thanhnt2410/forklift/Các-tính-năg-chính.docx

1. Các tính năng chính

Với mô hình hiện tại gồm ESP32 + Raspberry Pi 4B + LiDAR YDLiDAR X4 + 4 động cơ GA25A370 12V + BTS7960 + TB6600/NEMA23 nâng hạ vít me, xây dựng xe theo hướng AMR vận chuyển hàng có càng nâng, điều khiển thủ công và tự hành trong nhà.

a) Điều khiển di chuyển thủ công
- Tiến, lùi, rẽ trái, rẽ phải, dừng khẩn cấp.
- Điều khiển bằng bàn phím máy tính qua Serial ở giai đoạn thử nghiệm.
- Có thể phát triển điều khiển từ Raspberry Pi qua ROS 2.
- Tùy cấu hình bánh và cách đấu động cơ, có thể bổ sung đi ngang và xoay tại chỗ.
- Phần cứng: ESP32, BTS7960, 4 động cơ DC.
b) Quét môi trường và lập bản đồ 2D
- Quét tường, hành lang, kệ hàng và các vật cản phản xạ laser.
- Tạo bản đồ 2D khi xe di chuyển trong khu vực thử nghiệm.
- Hiển thị dữ liệu laser trên RViz2.
- Phần cứng: YDLiDAR X4.
- Phần mềm: ROS 2 Humble, driver YDLiDAR, SLAM Toolbox.
c) Tự định vị và tự hành đến điểm đích
- Xây dựng bản đồ trước, sau đó xác định vị trí xe trên bản đồ.
- Chọn điểm đích trên RViz2.
- Lập đường đi và điều chỉnh hướng di chuyển.
- Phần mềm: ROS 2 Humble, AMCL hoặc phương pháp định vị phù hợp, Nav2.
- Cần thêm odometry đáng tin cậy từ encoder và cấu hình đúng động học bánh xe.
d) Nâng hạ càng để lấy và đặt hàng
- Nâng càng đến độ cao yêu cầu.
- Hạ càng để lấy hoặc đặt kiện hàng.
- Điều khiển động cơ bước NEMA23 bằng TB6600.
- Có thể xây dựng các mức nâng định sẵn, ví dụ vị trí thấp, trung bình và cao.
e) Đo tốc độ và tính odometry bằng encoder
- Đọc xung encoder của từng bánh.
- Tính RPM thực tế và tốc độ bánh xe.
- So sánh tốc độ đặt với tốc độ thực để hiệu chỉnh bằng PID.
- Tính quãng đường và góc quay tương đối của xe.
- Đây là phần rất quan trọng để Nav2 điều hướng ổn định; cần hiệu chuẩn số xung và động học thực tế.

2. Các tính năng mở rộng nên có

Tính năng | Thiết bị/phần mềm sử dụng | Mức ưu tiên
Điều khiển bằng máy tính | ESP32 + Serial
Điều khiển bằng bàn phím trên ROS 2 | teleop_twist_keyboard | Nên có
Hiển thị bản đồ và vị trí xe | RViz2 + SLAM Toolbox | Nên có
Tự hành đến tọa độ đích | Nav2 + odometry | Mục tiêu chính
Phát hiện vật cản phía trước và xung quanh | LiDAR + Nav2 Costmap | Nên có
Đo RPM 4 bánh | 4 encoder | Nên có
Điều khiển tốc độ bánh bằng PID | ESP32 | Nên có
Nâng/hạ tự động theo vị trí | TB6600 + NEMA23 | Nên có
Dừng khẩn cấp | Nút E-stop và mạch ngắt nguồn động cơ | Bắt buộc về an toàn
Giám sát pin và điện áp | Cảm biến điện áp/dòng phù hợp | Mở rộng
Giao diện điều khiển trên máy tính | RViz2 hoặc giao diện riêng | Mở rộng
Tự động lấy hàng và giao hàng | Nav2 + điều khiển nâng hạ + logic nhiệm vụ | Mục tiêu nâng cao
