thanhnt2410/forklift/docs/images/Green_line.gif

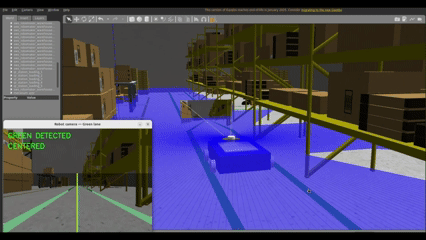
docs/images/Green_line.gif
