thanhnt2410/forklift/docs/images/Lift_system.gif

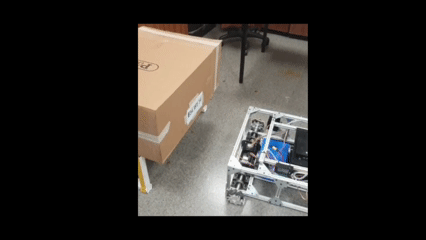
docs/images/Lift_system.gif
