thanhnt2410/forklift/docs/images/localization.gif

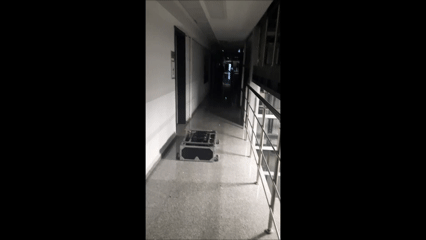
docs/images/localization.gif
