thanhnt2410/forklift/docs/images/mapping.gif

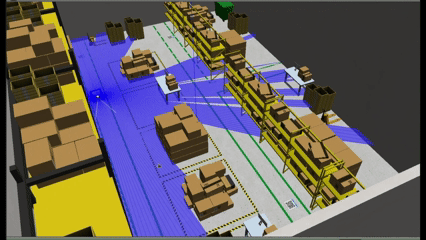
docs/images/mapping.gif
