thanhnt2410/forklift/src/forklift_navigation/maps/forklift_sim_probability.png

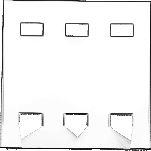
src/forklift_navigation/maps/forklift_sim_probability.png
