thanhnt2410/forklift/src/mecanum_navigation/maps/home_probability.png

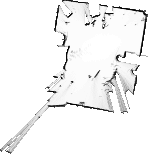
src/mecanum_navigation/maps/home_probability.png
