thanhnt2410/forklift/src/forklift_description/cad_source/meshes/base_link.STL

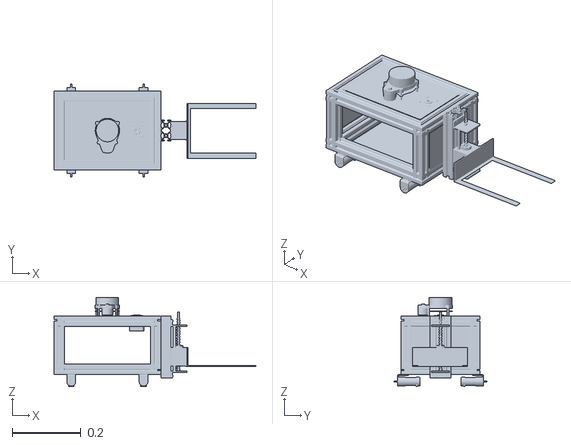
[picture p9: CAD file, 2026-10-24]
src/forklift_description/cad_source/meshes/base_link.STL
0.586 x 0.269 x 0.26
