thanhnt2410/forklift/src/forklift_description/meshes/lift_drive_gear.stl

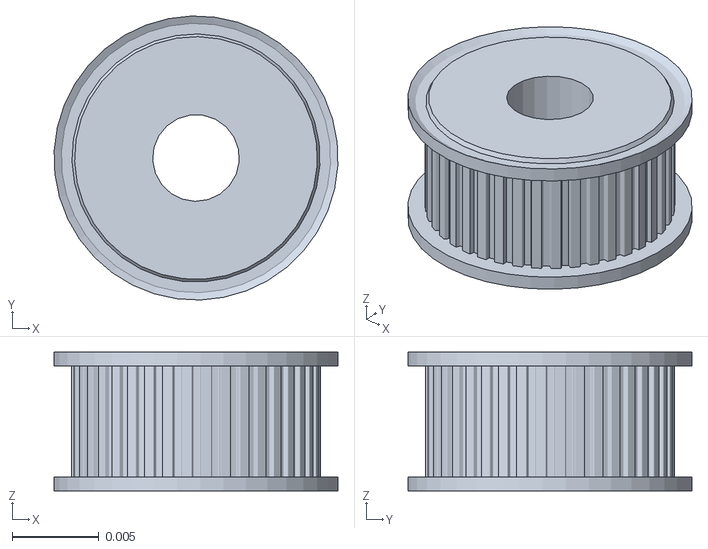
[picture p10: CAD file, 2026-10-24]
src/forklift_description/meshes/lift_drive_gear.stl
0.0164 x 0.0164 x 0.008
