thanhnt2410/forklift/src/forklift_description/cad_source/meshes/banh2_Link.STL

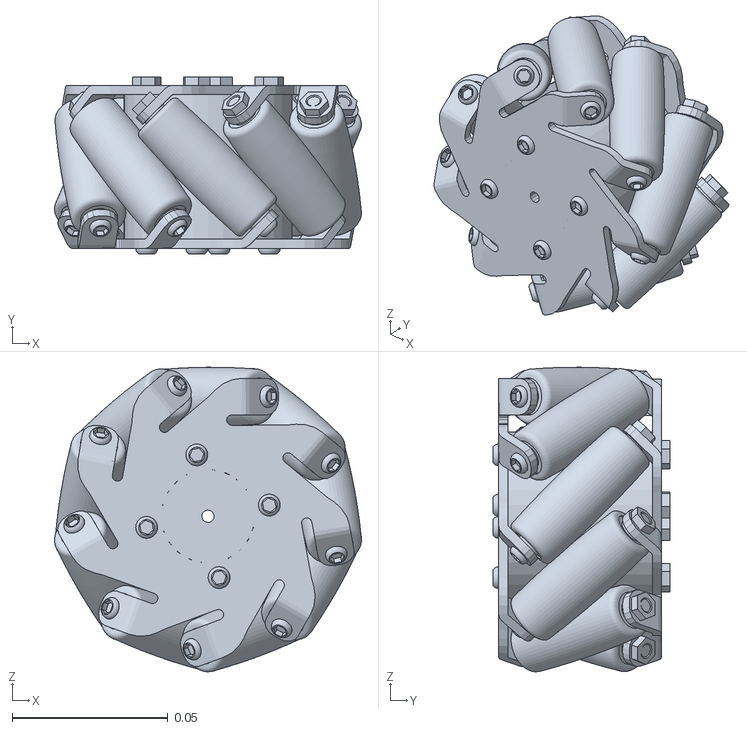
[picture p11: CAD file, 2026-10-24]
src/forklift_description/cad_source/meshes/banh2_Link.STL
0.0985 x 0.0568 x 0.0977
