thanhnt2410/forklift/src/forklift_description/cad_source/meshes/lidar_Link.STL

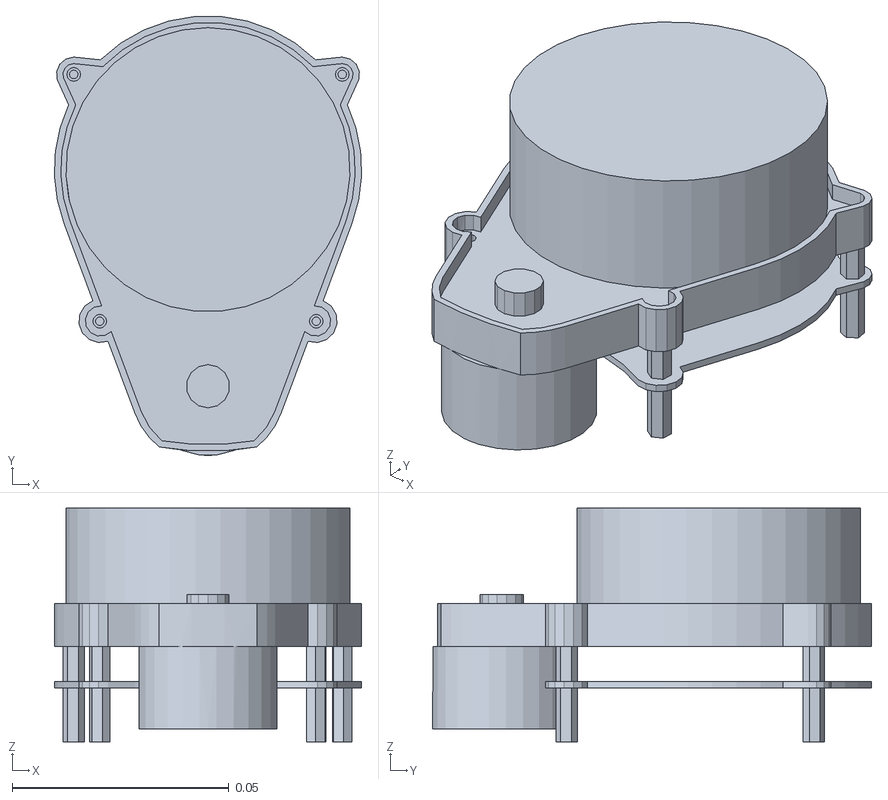
[picture p12: CAD file, 2026-10-24]
src/forklift_description/cad_source/meshes/lidar_Link.STL
0.0709 x 0.101 x 0.054
