thanhnt2410/forklift/src/forklift_description/cad_source/meshes/step_Link.STL

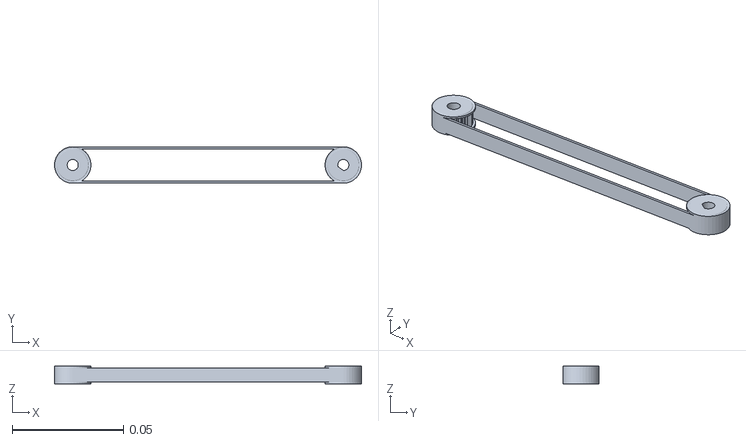
[picture p13: CAD file, 2026-10-24]
src/forklift_description/cad_source/meshes/step_Link.STL
0.138 x 0.0164 x 0.008
