thanhnt2410/forklift/src/forklift_description/cad_source/meshes/banhrang2_Link.STL

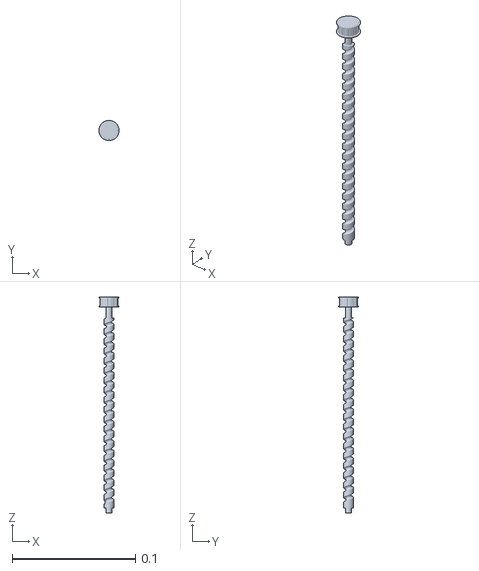
[picture p14: CAD file, 2026-10-24]
src/forklift_description/cad_source/meshes/banhrang2_Link.STL
0.0164 x 0.0164 x 0.175
