thanhnt2410/forklift/src/forklift_description/meshes/lift_carriage.stl

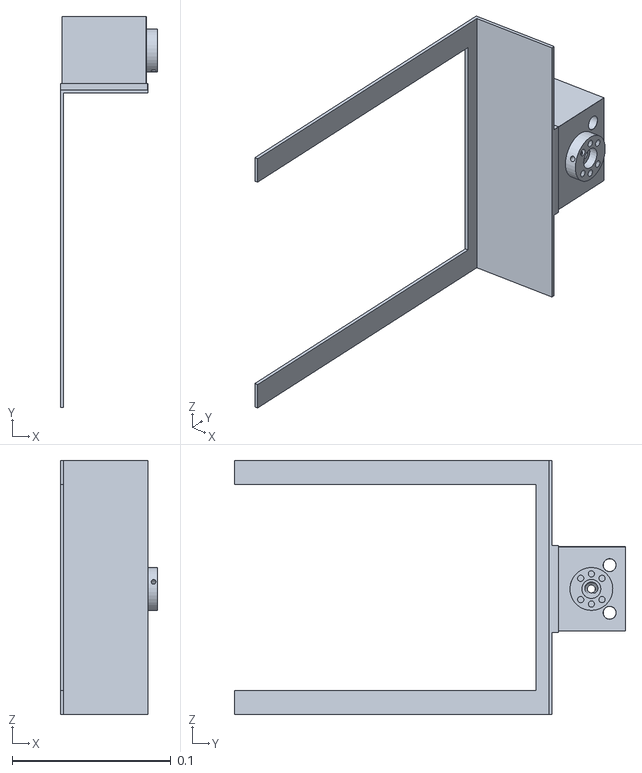
[picture p15: CAD file, 2026-10-24]
src/forklift_description/meshes/lift_carriage.stl
0.0611 x 0.246 x 0.16
