thanhnt2410/forklift/src/forklift_description/meshes/chassis.stl

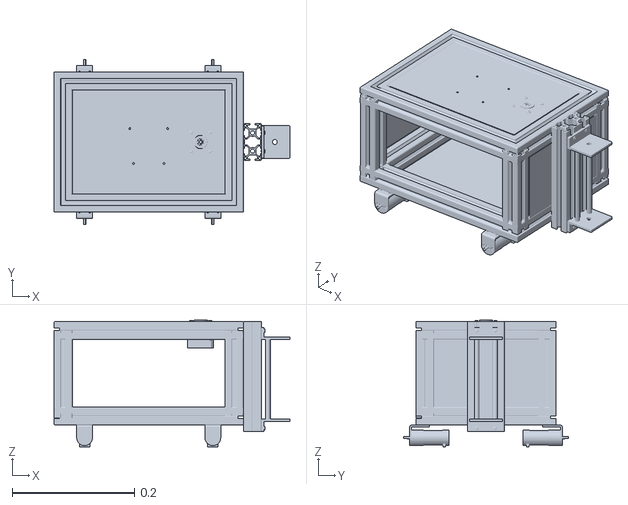
[picture p16: CAD file, 2026-10-24]
src/forklift_description/meshes/chassis.stl
0.386 x 0.269 x 0.208
