thanhnt2410/forklift/(list of files, cad)

Other CAD files:
src/forklift_description/cad_source/meshes/banh1_Link.STL
src/forklift_description/meshes/front_left_wheel.stl
src/forklift_description/cad_source/meshes/banh3_Link.STL
src/forklift_description/meshes/rear_left_wheel.stl
src/forklift_description/cad_source/meshes/banh4_Link.STL
src/forklift_description/meshes/rear_right_wheel.stl
