thanhnt2410/forklift/results/final/dynamic_mission/cancel/mission.csv

t | state | robot_x | robot_y | robot_yaw | pallet_x | pallet_y | pallet_z | pallet_yaw | vx | vy | wz | load | map_x | map_y | map_yaw
505829.196282791 | IDLE | 2.664535259100348e-21 | -4.996264735268596e-22 | -8.326672684688766e-23 | 0.95 | 0.65 | -1.8797065771958278e-11 | -5.383505475921094e-21 | 0.0 | 0.0 | 0.0 | False
505829.316199245 | IDLE | 2.664535259100348e-21 | -4.996264735268596e-22 | -8.326672684688766e-23 | 0.95 | 0.65 | -1.8797065771958278e-11 | -5.383505475921094e-21 | 0.0 | 0.0 | 0.0 | False
505829.416253594 | IDLE | 2.664535259100348e-21 | -4.996264735268596e-22 | -8.326672684688766e-23 | 0.95 | 0.65 | -1.8797065771958278e-11 | -5.383505475921094e-21 | 0.0 | 0.0 | 0.0 | False
505829.536256974 | IDLE | 2.664535259100348e-21 | -4.996264735268596e-22 | -8.326672684688766e-23 | 0.95 | 0.65 | -1.8797065771958278e-11 | -5.383505475921094e-21 | 0.0 | 0.0 | 0.0 | False
505829.658235333 | IDLE | 2.664535259100348e-21 | -4.996264735268596e-22 | -8.326672684688766e-23 | 0.95 | 0.65 | -1.8797065771958278e-11 | -5.383505475921094e-21 | 0.0 | 0.0 | 0.0 | False
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
