thanhnt2410/forklift/results/final/dynamic_mission/cancel_loaded/mission.csv

t | state | robot_x | robot_y | robot_yaw | pallet_x | pallet_y | pallet_z | pallet_yaw | vx | vy | wz | load | map_x | map_y | map_yaw
505093.903661811 | IDLE | 5.329070518200689e-21 | -9.993443406131062e-22 | -1.6653345369377553e-22 | 0.95 | 0.65 | -1.8797065771958278e-11 | -5.383505475921094e-21 | 0.0 | 0.0 | 0.0 | False
505094.003791012 | IDLE | 5.329070518200689e-21 | -9.993443406131062e-22 | -1.6653345369377553e-22 | 0.95 | 0.65 | -1.8797065771958278e-11 | -5.383505475921094e-21 | 0.0 | 0.0 | 0.0 | False
505094.115979718 | IDLE | 8.881784197001143e-21 | -1.6657915047346703e-21 | -2.775557561562927e-22 | 0.95 | 0.65 | -1.8797065771958278e-11 | -5.383505475921094e-21 | 0.0 | 0.0 | 0.0 | False
505094.217679768 | IDLE | -3.203749560791486e-12 | 1.1670537655607396e-16 | -1.2320145530614313e-16 | 0.95 | 0.65 | -1.8797065771958278e-11 | -5.383505475921094e-21 | 0.0 | 0.0 | 0.0 | False
505094.320802347 | IDLE | -3.1967335971082835e-12 | 1.155458278260727e-16 | 3.805693524072221e-18 | 0.95 | 0.65 | -1.8797065771958278e-11 | -5.383505475921094e-21 | 0.0 | 0.0 | 0.0 | False
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
