thanhnt2410/forklift/results/final/dynamic_mission/cancel_retreat/mission.csv

t | state | robot_x | robot_y | robot_yaw | pallet_x | pallet_y | pallet_z | pallet_yaw | vx | vy | wz | load | map_x | map_y | map_yaw
505613.166576521 | IDLE | 5.329070518200689e-21 | -9.993443406131062e-22 | -1.6653345369377553e-22 | 0.95 | 0.65 | -1.8797065771958278e-11 | -5.383505475921094e-21 | 0.0 | 0.0 | 0.0 | False
505613.266662494 | IDLE | 5.329070518200689e-21 | -9.993443406131062e-22 | -1.6653345369377553e-22 | 0.95 | 0.65 | -1.8797065771958278e-11 | -5.383505475921094e-21 | 0.0 | 0.0 | 0.0 | False
505613.366690486 | IDLE | 2.0516921495072616e-19 | -3.8296269111448573e-20 | -6.300515664747855e-21 | 0.95 | 0.65 | -1.8797065771958278e-11 | -5.383505475921094e-21 | 0.0 | 0.0 | 0.0 | False
505613.476316733 | IDLE | -3.2242751532534784e-12 | 1.1681044982727404e-16 | 6.959117667158027e-18 | 0.95 | 0.65 | -1.8797065771958278e-11 | -5.383505475921094e-21 | 0.0 | 0.0 | 0.0 | False
505613.578556104 | IDLE | -3.1919660442139026e-12 | 1.1533879076530136e-16 | 2.866845469283098e-18 | 0.95 | 0.65 | -1.8797065771958278e-11 | -5.383505475921094e-21 | 0.0 | 0.0 | 0.0 | False
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
