thanhnt2410/forklift/results/final/dynamic_mission/missing_pallet/mission.csv

t | state | robot_x | robot_y | robot_yaw | pallet_x | pallet_y | pallet_z | pallet_yaw | vx | vy | wz | load | map_x | map_y | map_yaw
505788.208965822 | IDLE | 5.329070518200689e-21 | -9.993443406131062e-22 | -1.6653345369377553e-22 | 0.95 | 0.65 | -1.8797065771958278e-11 | -5.383505475921094e-21 | 0.0 | 0.0 | 0.0 | False
505788.309220934 | IDLE | 5.329070518200689e-21 | -9.993443406131062e-22 | -1.6653345369377553e-22 | 0.95 | 0.65 | -1.8797065771958278e-11 | -5.383505475921094e-21 | 0.0 | 0.0 | 0.0 | False
505788.414321522 | IDLE | -1.3649508706186334e-12 | 4.979940459223876e-17 | -1.2315060863321484e-16 | 0.95 | 0.65 | -1.8797065771958278e-11 | -5.383505475921094e-21 | 0.0 | 0.0 | 0.0 | False
505788.516046535 | IDLE | -3.2258210401427543e-12 | 1.1687960493035809e-16 | 7.088909870699133e-18 | 0.95 | 0.65 | -1.8797065771958278e-11 | -5.383505475921094e-21 | 0.0 | 0.0 | 0.0 | False
505788.616062694 | IDLE | -3.1919660442139026e-12 | 1.1533879076530136e-16 | 2.866845469283098e-18 | 0.95 | 0.65 | -1.8797065771958278e-11 | -5.383505475921094e-21 | 0.0 | 0.0 | 0.0 | False
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
