thanhnt2410/forklift/results/final/dynamic_mission/nominal/mission.csv

t | state | robot_x | robot_y | robot_yaw | pallet_x | pallet_y | pallet_z | pallet_yaw | vx | vy | wz | load | map_x | map_y | map_yaw
505355.83696218 | IDLE | 5.329070518200689e-21 | -9.993443406131062e-22 | -1.6653345369377553e-22 | 0.95 | 0.65 | -1.8797065771958278e-11 | -5.383505475921094e-21 | 0.0 | 0.0 | 0.0 | False
505355.9568166 | IDLE | 5.329070518200689e-21 | -9.993443406131062e-22 | -1.6653345369377553e-22 | 0.95 | 0.65 | -1.8797065771958278e-11 | -5.383505475921094e-21 | 0.0 | 0.0 | 0.0 | False
505356.057495927 | IDLE | -2.8399713232431403e-12 | 1.0347196321373233e-16 | -1.2318442889347137e-16 | 0.95 | 0.65 | -1.8797065771958278e-11 | -5.383505475921094e-21 | 0.0 | 0.0 | 0.0 | False
505356.1626632 | IDLE | -3.201927957424886e-12 | 1.1578344205757187e-16 | 4.5900658202533585e-18 | 0.95 | 0.65 | -1.8797065771958278e-11 | -5.383505475921094e-21 | 0.0 | 0.0 | 0.0 | False
505356.262877041 | IDLE | -3.1889004815557215e-12 | 1.1519857523973847e-16 | 1.963313044791957e-18 | 0.95 | 0.65 | -1.8797065771958278e-11 | -5.383505475921094e-21 | 0.0 | 0.0 | 0.0 | False
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
