thanhnt2410/forklift/results/final/dynamic_mission/legacy/mission.csv

t | sim_t | state | load | pallet_x | pallet_y | pallet_z | robot_z | robot_roll | robot_pitch | raw_lift | robot_yaw | pallet_yaw | robot_x | robot_y | cmd_x | cmd_y | cmd_w | nav_cmd_x | nav_cmd_w | mission_cmd_x | nav_cmd_y | source | odom_vy | map_x | map_y | map_yaw
505870.76597848 | 0.003 | IDLE | False | 0.95 | 0.65 | -1.8797065771958278e-11 | 0.004941200000000001 | -7.993605777301129e-21 | 5.145439123960323e-34 | 0.0 | -1.6653345369377553e-22 | -5.383505475918921e-21 | 5.329070518200689e-21 | -9.993443406131062e-22 | 0.0 | 0.0 | 0.0 | 0.0 | 0.0 | 0.0 | 0.0 | NAV2 | 0.0
505870.879032238 | 0.003 | IDLE | False | 0.95 | 0.65 | -1.8797065771958278e-11 | 0.004941200000000001 | -7.993605777301129e-21 | 5.145439123960323e-34 | 0.0 | -1.6653345369377553e-22 | -5.383505475918921e-21 | 5.329070518200689e-21 | -9.993443406131062e-22 | 0.0 | 0.0 | 0.0 | 0.0 | 0.0 | 0.0 | 0.0 | NAV2 | 0.0
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
