thanhnt2410/forklift/results/final/dynamic_mission/validation/rviz.png

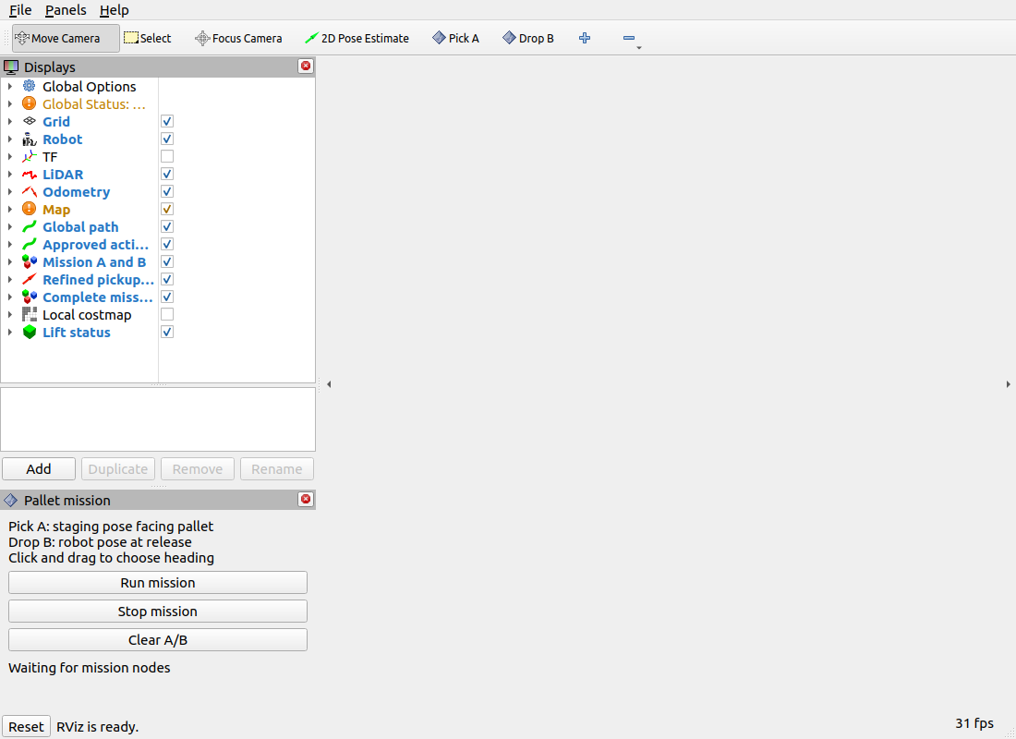
results/final/dynamic_mission/validation/rviz.png
