thanhnt2410/forklift/results/final/early_detection/trajectories.png

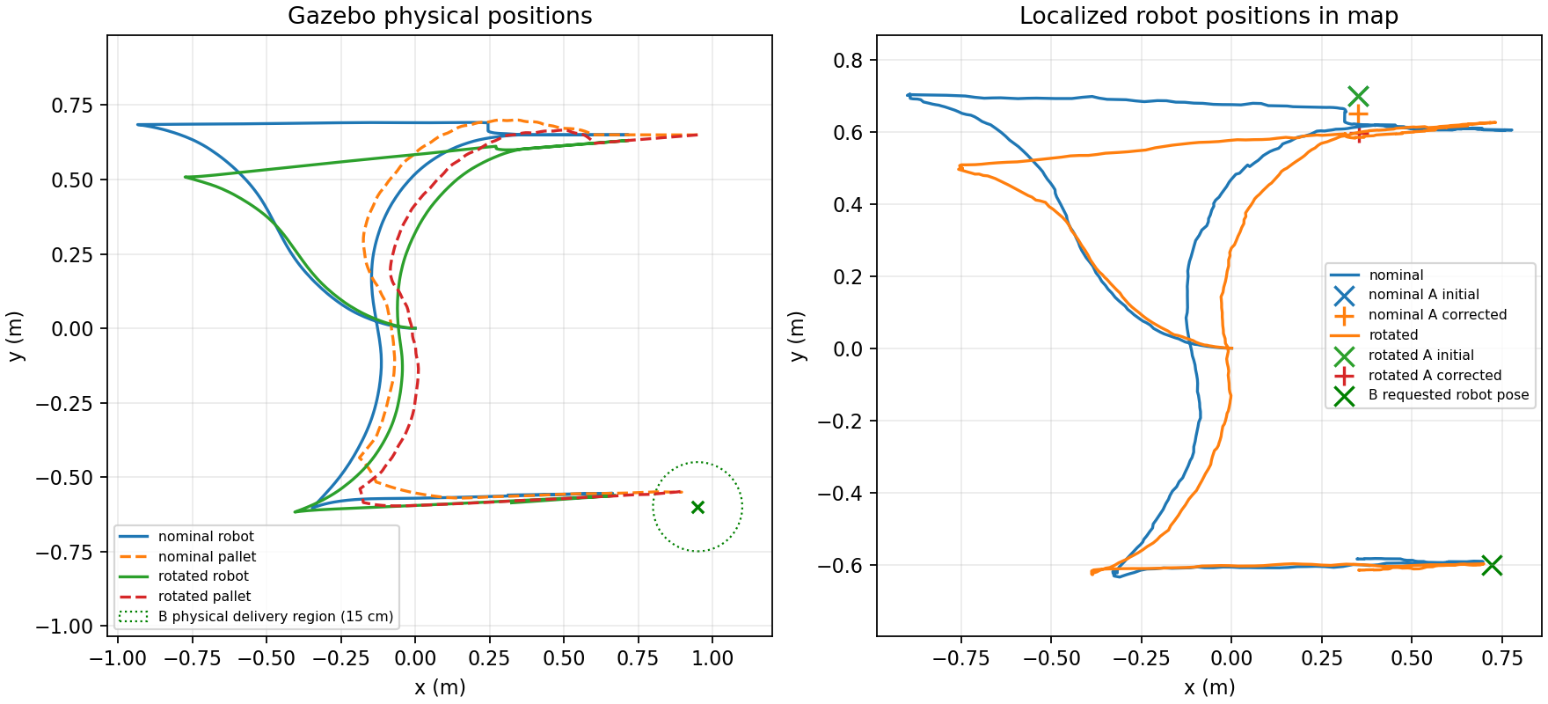
results/final/early_detection/trajectories.png
