thanhnt2410/forklift/results/final/path_pipeline_fix/trajectories.png

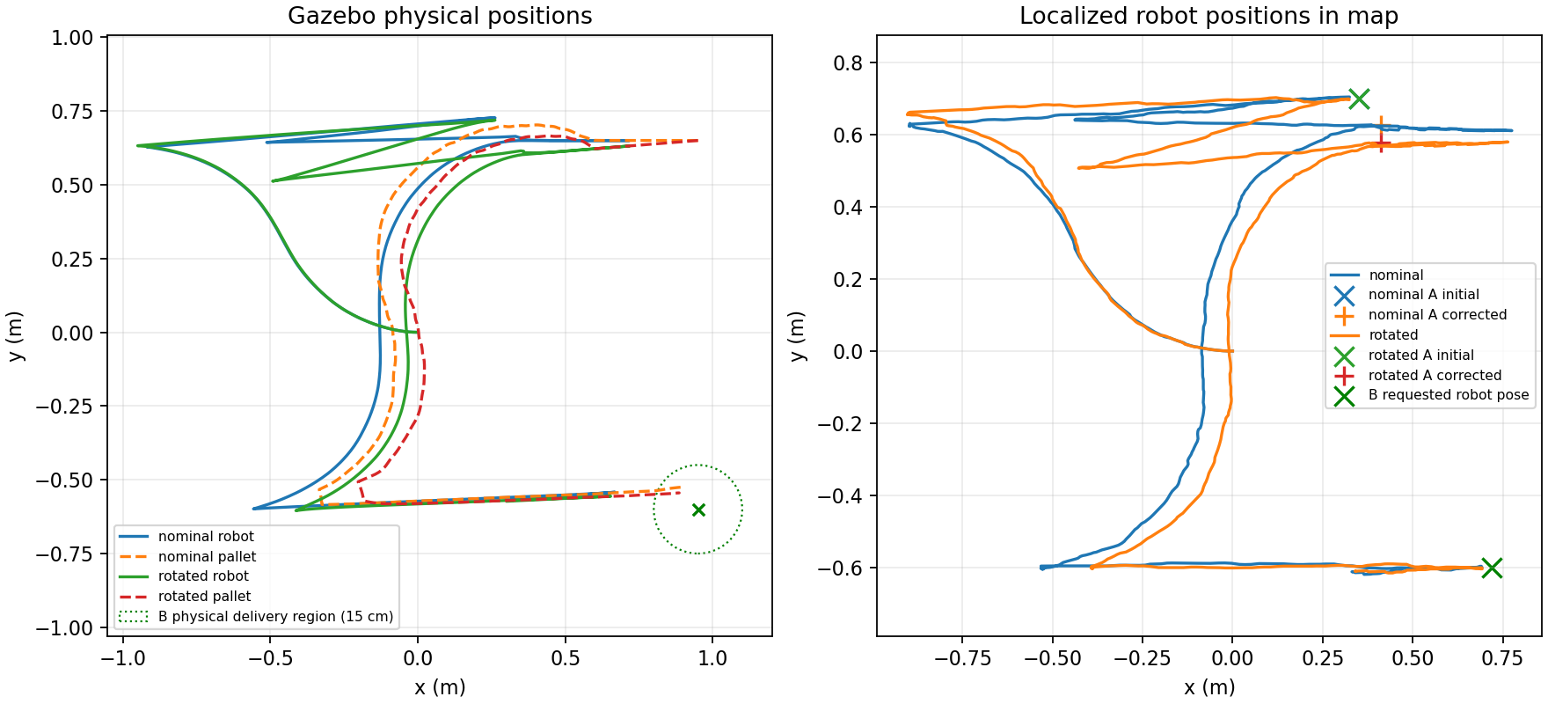
results/final/path_pipeline_fix/trajectories.png
