thanhnt2410/forklift/(commit log)

2026-10-24 initial code
    [banh1_Link.STL, banh2_Link.STL, banh3_Link.STL, banh4_Link.STL, banhrang1_Link.STL, banhrang2_Link.STL, base_link.STL, can_Link.STL]
2026-10-24 feat: add ESP32 serial teleop and single-switch lift preset
2026-10-24 fix: release ESP32 serial modem lines and expose RX diagnostics
    [esp32_bridge.py]
2026-10-24 feat: simplify ESP32 serial protocol to plain CSV
2026-10-25 feat: add real LiDAR mapping and ESP32 serial discovery
    Add hardware LiDAR bringup, CAD-based real mapping, telemetry-based USB detection and Pi source sync. Update manual ESP32 control, pulse lift behavior, board pin mapping and standalone motor test documentation.
2026-10-25 new code fix firmware
    [board_config.h, esp32.yaml, esp32_bridge.py, firmware_core.cpp, firmware_core.h]
2026-10-26 fix lidar
2026-10-28 Update: PID và tốc độ lift firmware thực tế nạp (28/10)
    - Cập nhật board_config.h:
    * PI bánh: Kp=0.032, Ki=0.16, Kd=0.0 (tất cả 4 bánh)
    * Tốc độ nâng: 2500 xung/s, gia tốc 3000 xung/s²
    * Tốc độ hạ: 2000 xung/s (mượt tới công tắc đáy)
    * GPIO công tắc dưới: 32 → 15
    * Lệnh R nâng: 2000 → 20000 xung (~10 cm)
    * Timeout hạ: 3s → 30s
    * step_up_level: true → false (R nâng, F/H hạ)
    * Thêm comment tiếng Việt chi tiết để giải thích từng tham số
    - Cập nhật CLAUDE.md §3.2 và §6.3:
    * Bảng firmware specs với PID và tốc độ đã nạp
    * Bảng esp32.yaml với giá trị lift mới
    *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
2026-10-28 feat: add RViz pallet pickup and delivery missions
    Add dynamic A/B missions with early LiDAR alignment, validated route planning, pickup, delivery and retreat. Restore the FollowPath pipeline and include simulation verification reports.
    [mission.csv]
2026-10-28 fix: warn on raised forks and MCU encoder spikes
    Allow hardware driving with stationary raised forks and discard implausible encoder samples without latching faults in the bench profile. Preserve lift-motion and emergency interlocks, filter odometry spikes, and document validation and firmware update requirements.
    [board_config.h, esp32.yaml, esp32_bridge.py, firmware_core.cpp, firmware_core.h]
2026-11-08 feat: rubber skid-steer wheels, MPU driver, obstacle avoidance and firmware updates
    - wheel_type rubber|mecanum across bringup launches; diff_drive controller,
    skid kinematics in esp32_bridge, wheels_real.yaml profiles
    - MPU6500 driver, mount check and EKF config for the real robot
    - scan safety, obstacle tracking, auto localize and avoidance for missions
    - bays world/map, CycloneDDS unicast config, Pi diagnostics script
    - firmware: PWM ceiling, FR encoder on GPIO32, lower switch GPIO15,
    wheels_moved_during_lift fault tuning
    - docs and CLAUDE.md updated
    [bays.sdf, forklift.urdf.xacro, forklift_cad.urdf.xacro, robot.yaml, ros2_control.xacro]
